kvic68/PhaseRegulator/Scheme/Readme.md

Схема регулятора в виде картинки в файле shemaa.gif

В формате sPlan 6 в файле stab.spl

Перечень деталей 
 
C1	= 2,2uF 400V,
C2	= 1000uF 25V, 
C3	= 0.01-0.047 400V,
C4	= 4.7uF 10V,
C5	= 0.1-1.0 uF
 
DA1	= PC817,
DA2	= TL431,
DA3	= PC817,
DA4	= MOC3052
 
DD1	= ADUM1201,
DD2	= Arduino nano v3,
DD3	= ADUM1250
 
R1	= 330,
R2	= 360k,
R3	= 360k,
R4	= 330,
R5	= 1k,
R6	= 47 0.5-1W,
R7	= 330,

R8	= 4.7k,
R9	= 360k,
R10	= 360k,
R11	= 330,
R12	= 4.7k,
R13	= 1k
 
RP1	= 100k
 
SW1	= Encoder EC11 Type
 
U1	= OLED Display
 
VD1	= 1N4007,
VD2	= 1N5349,
VD3	= SMAJ5.0,
VD4	= SM6T12
 
VS1	= BTA41-600
