kvic68/PhaseRegulator/Plate/Readme.md

2Bottom
Здесь представлены два варианта возможной платы.

Первая с возможностью управления только по UART.

Вторая и по UART и по I2C.
Оба варианта в формате Sprint Layout 6.

Файл stab.lay6

Гербер файлы в архивах Gerber1 Gerber2 соответственно.
