kvic68/PhaseRegulator/Plate/1Bottom.JPG

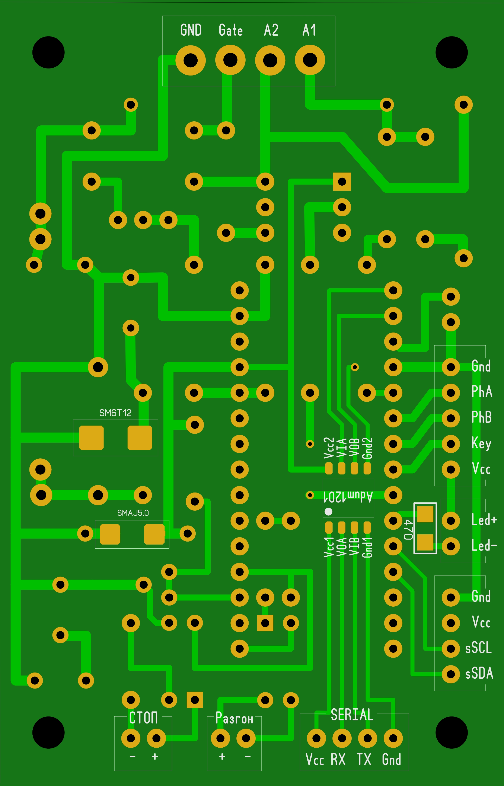
Plate/1Bottom.JPG
