kvic68/PhaseRegulator/Plate/1Top.JPG

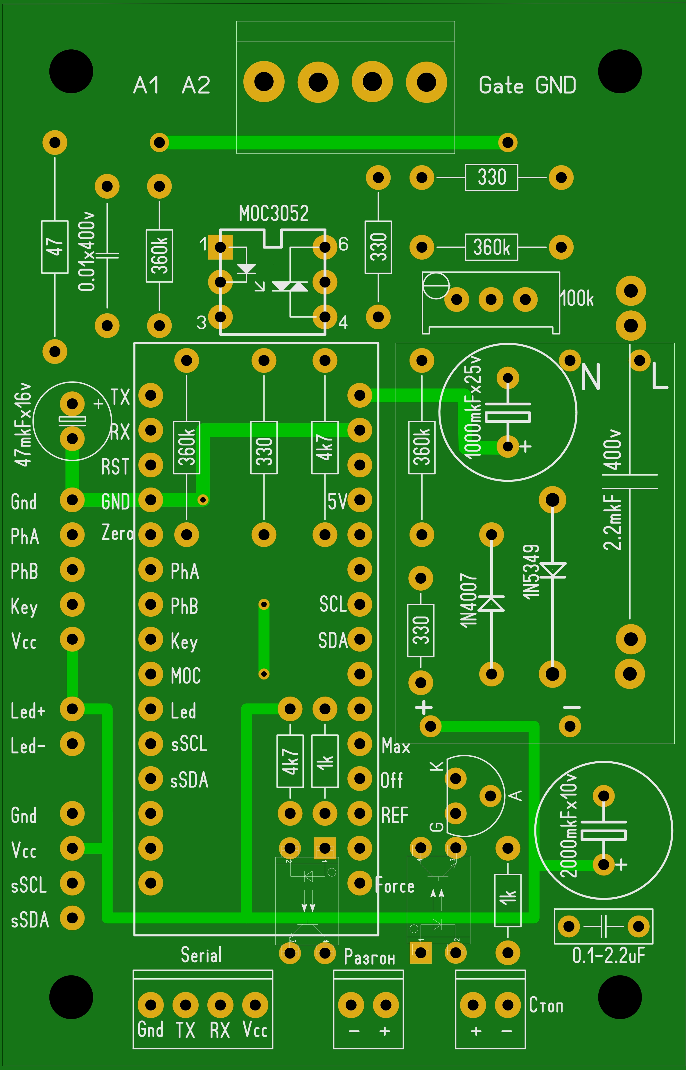
Plate/1Top.JPG
