kvic68/PhaseRegulator/Plate/2Bottom.JPG

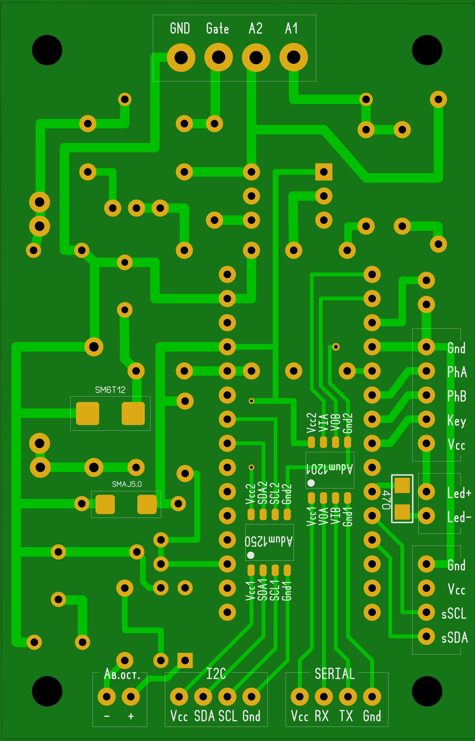
Plate/2Bottom.JPG
