kvic68/PhaseRegulator/Plate/2Top.JPG

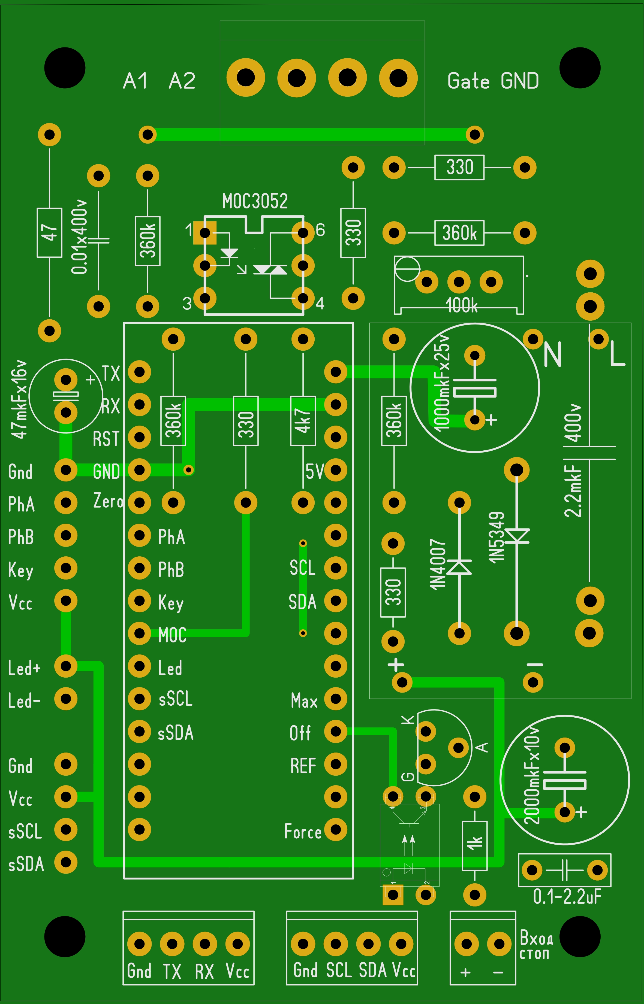
Plate/2Top.JPG
