kvic68/PhaseRegulator/Scheme/shemaa.gif

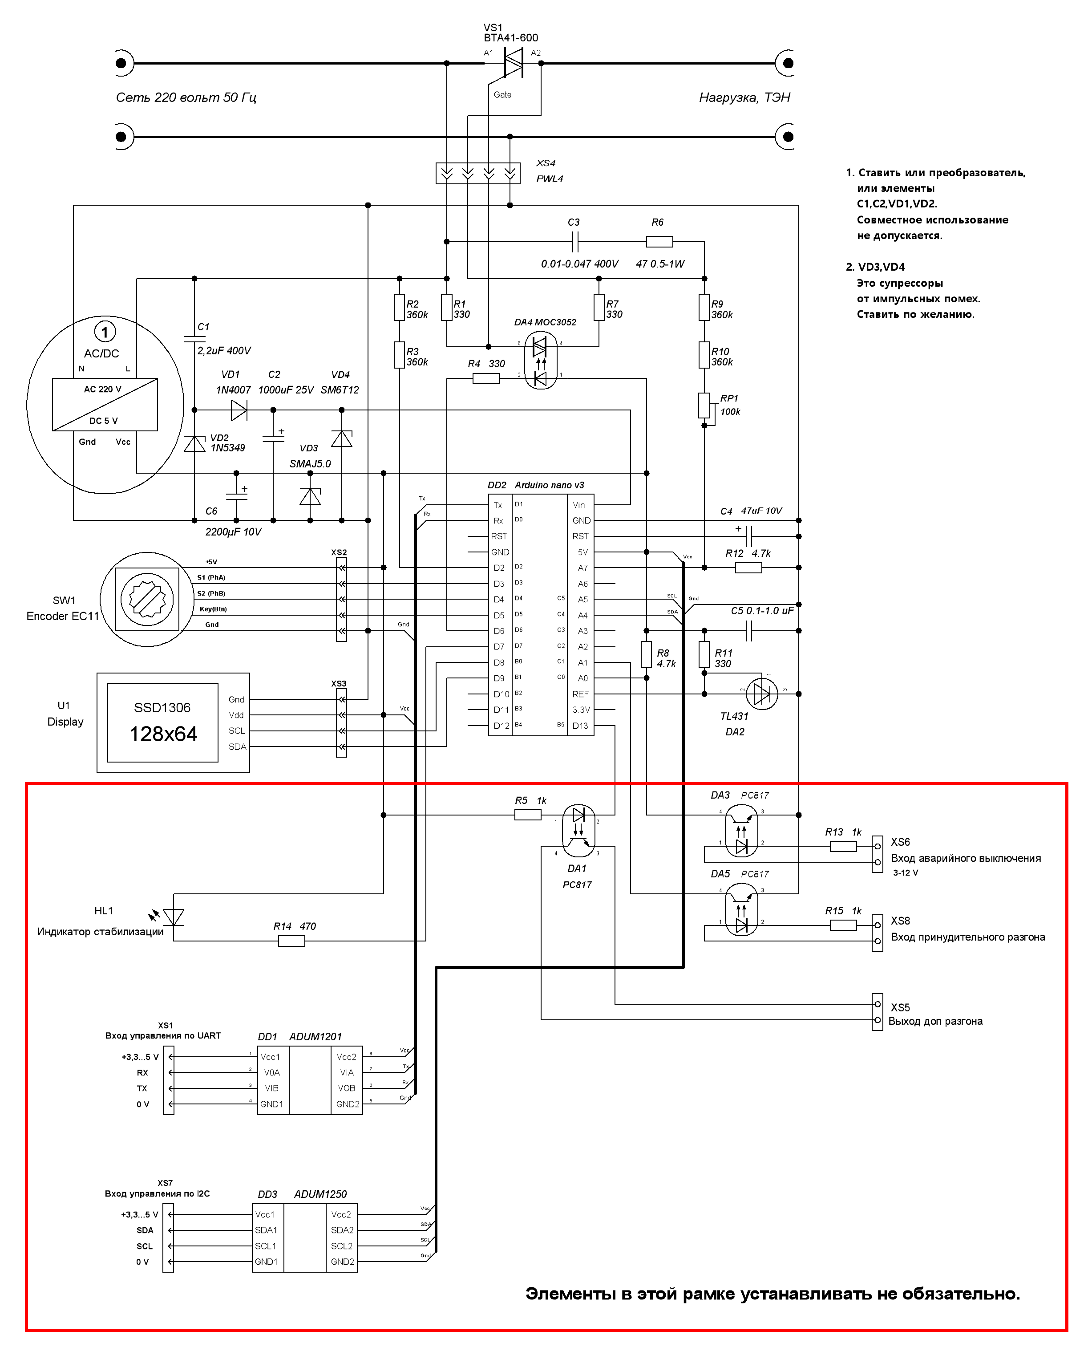
Scheme/shemaa.gif
