kvic68/PhaseRegulator/(list of files, drawings)

Other design files:
Plate/stab.lay6
Scheme/stab.lay6
stab.lay6
