kvic68/PhaseRegulator/(commit log)

2025-05-05 05-05-2025 с подтяжками
2025-05-13 Программатор
2025-05-29 Изолирующие рамки для индикатора и энкодера
2025-06-03 03-06-2025 с ускорениями
2025-06-03 03-06-2025 с инвертированным входом внешнего стопа
2025-06-03 03-06-2025 с АЦП на входе А2
2025-06-04 04-06-2025 с инвертированным входом внешнего стопа A0
2025-06-04 04-06-2025 с АЦП на входе А2
